KrystianRuszczak/Frequency_Meter_PCB/pcb_design/Frequency_Meter.kicad_pcb

## KiCad design pcb_design/Frequency_Meter.kicad_pcb (2026-11-03)

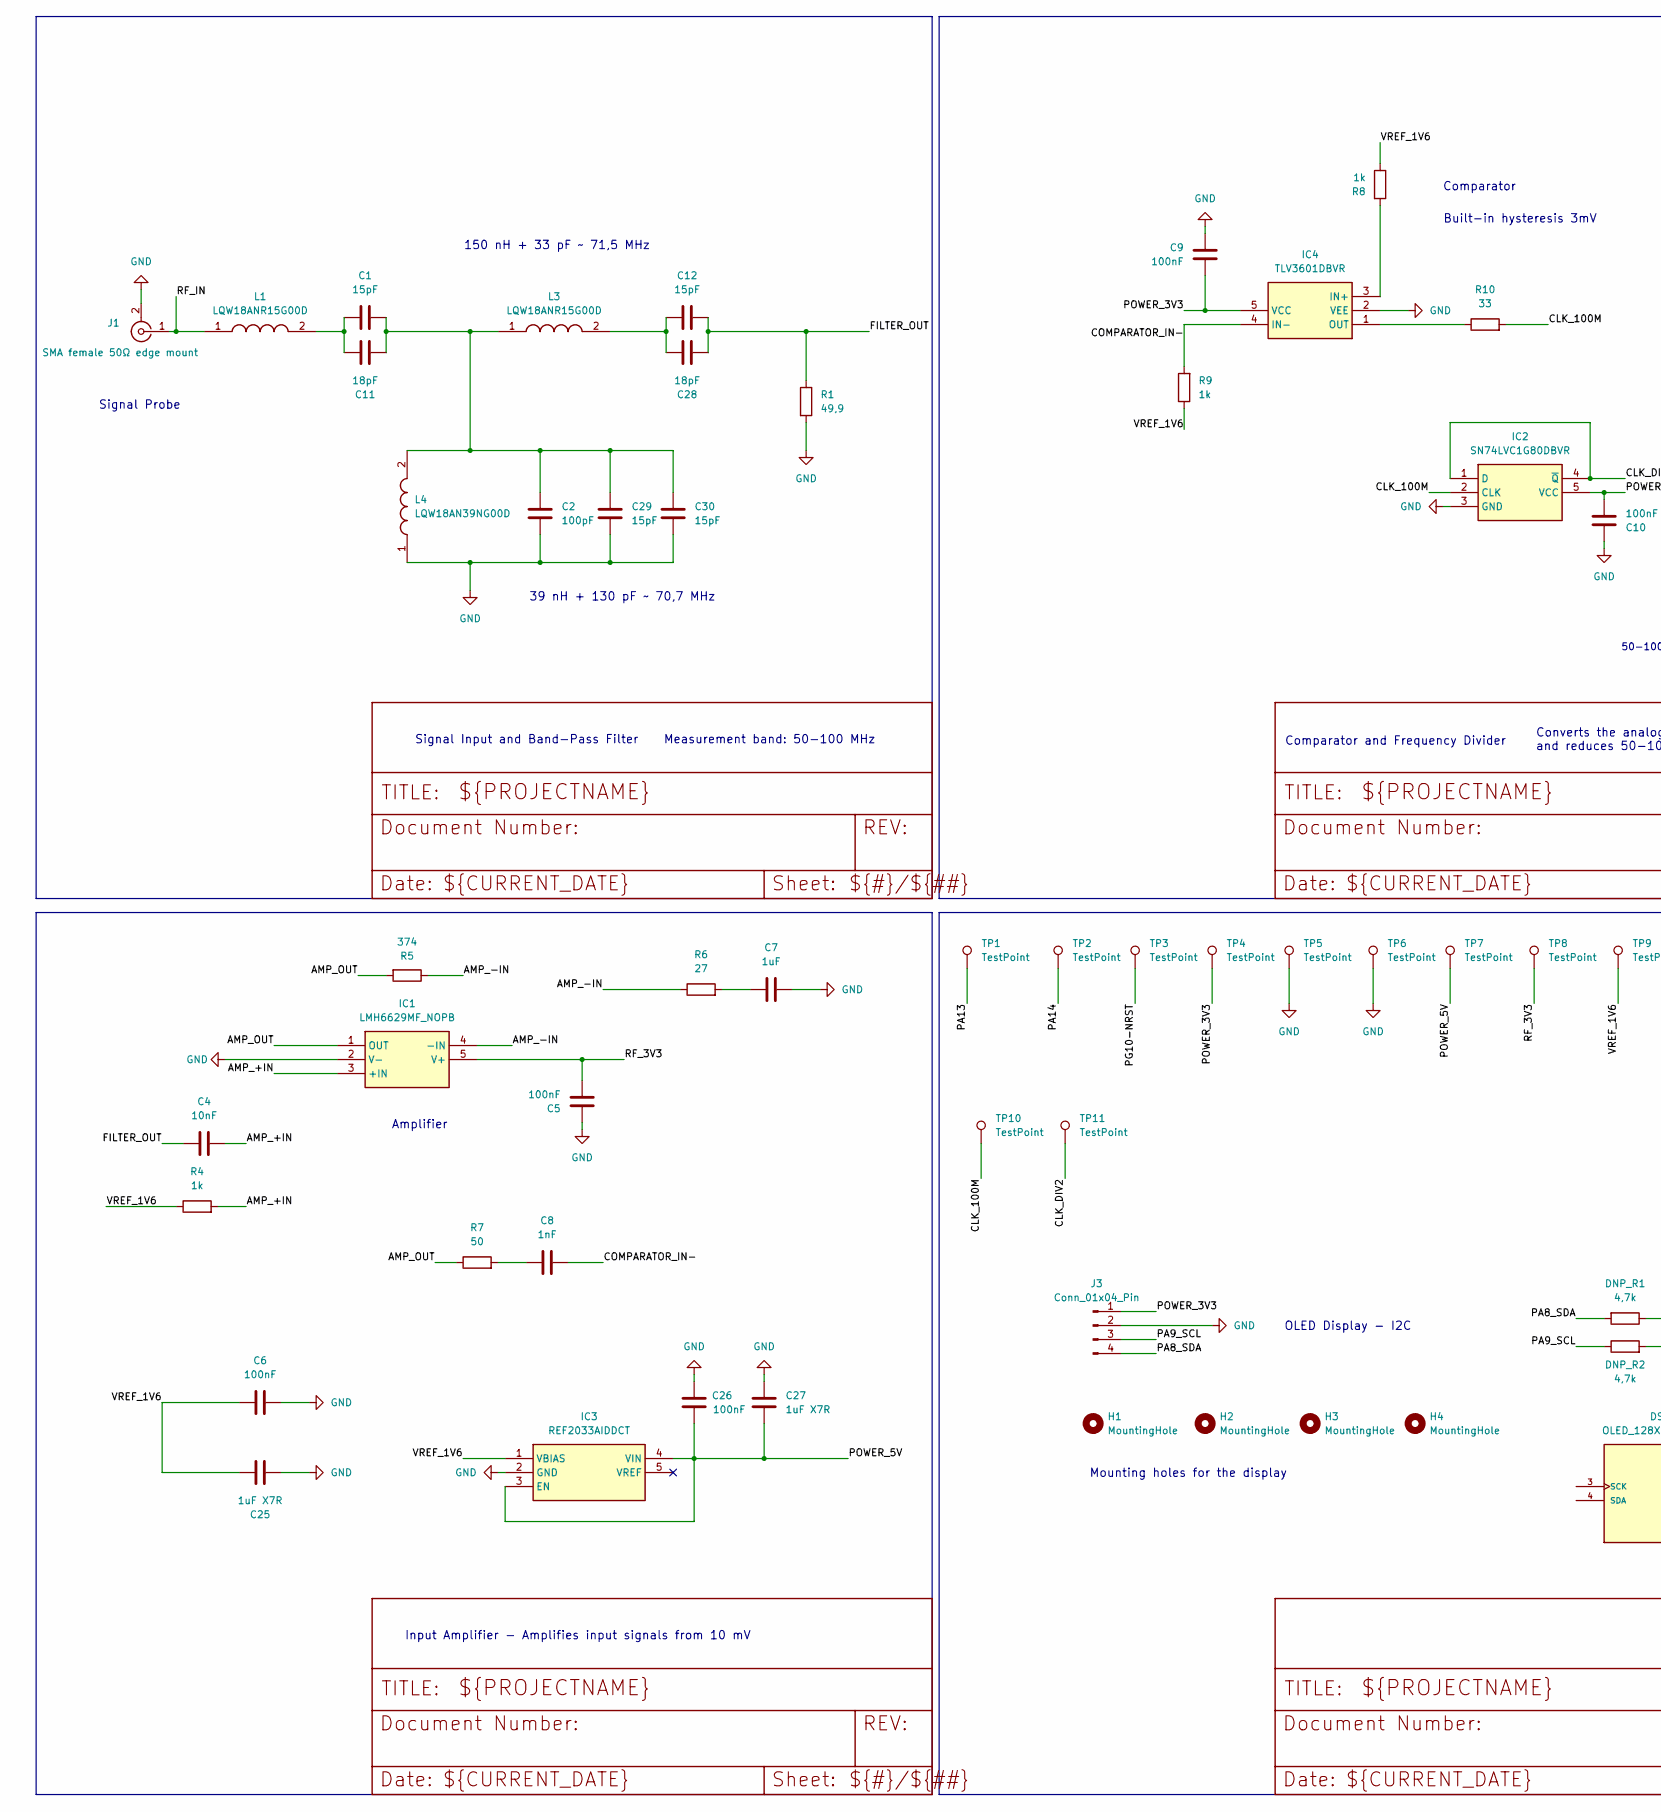
[picture p1: schematic Frequency_Meter.kicad_sch, FREQUENCY METER 50 - 100 MHz, part in row 1, column 1]

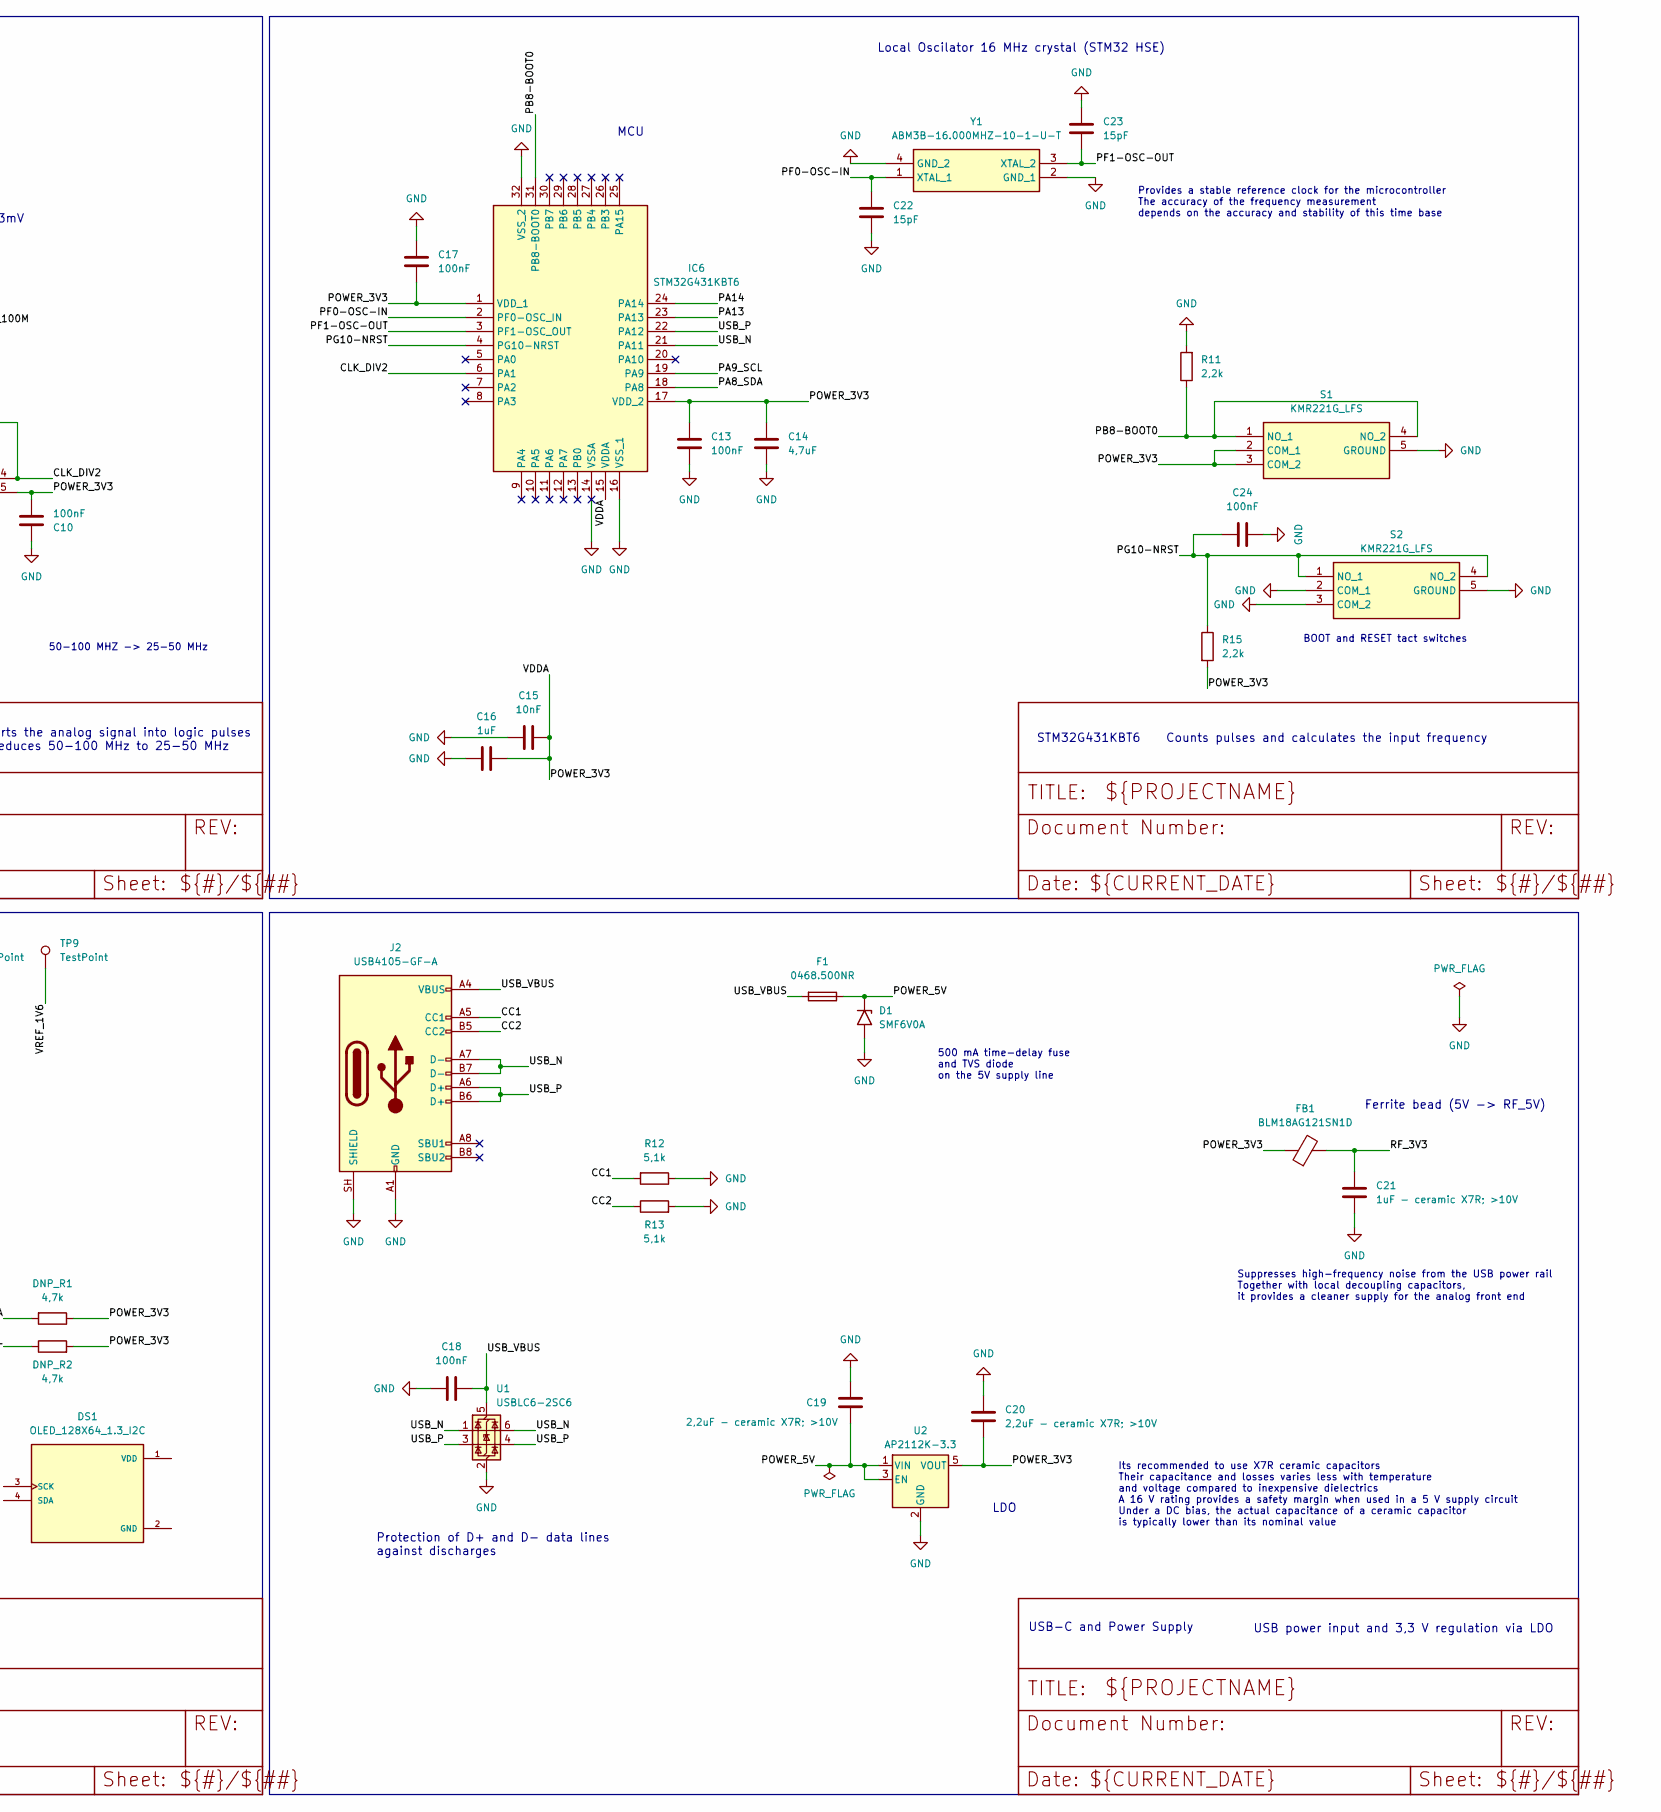
[picture p2: schematic Frequency_Meter.kicad_sch, FREQUENCY METER 50 - 100 MHz, part in row 1, column 2]

Parts:
C1, C12, C22, C23, C29, C30: 15pF; C_0603_1608Metric
C2: 100pF; C_0603_1608Metric
C4, C15: 10nF; C_0805_2012Metric
C5, C6, C9, C10, C13, C17, C18, C24, C26: 100nF; C_0603_1608Metric
C7, C16: 1uF; C_0805_2012Metric
C8: 1nF; C_0603_1608Metric
C11, C28: 18pF; C_0603_1608Metric
C14: 4,7uF; C_0805_2012Metric
C19, C20: 2,2uF - ceramic X7R; >10V; C_0805_2012Metric
C21: 1uF - ceramic X7R; >10V; C_0805_2012Metric
C25, C27: 1uF X7R; C_0805_2012Metric
D1: SMF6V0A; D_SMF
DNP_R1, DNP_R2: 4,7k; R_0603_1608Metric
DS1: OLED_128X64_1.3_I2C; LCD_OLED_128X64_1.3_I2C; PARTREV NA
F1: 0468.500NR; Fuse_1206_3216Metric
FB1: BLM18AG121SN1D; L_0603_1608Metric
H1, H2, H3, H4: MountingHole; MountingHole_2.2mm_M2
IC1: LMH6629MF_NOPB; SOT95P280X145-5N; Mouser Part Number 926-LMH6629MF/NOPB
IC2: SN74LVC1G80DBVR; SOT95P280X145-5N; Mouser Part Number 595-SN74LVC1G80DBVR
IC3: REF2033AIDDCT; SOT95P280X110-5N; Mouser Part Number 595-REF2033AIDDCT
IC4: TLV3601DBVR; SOT95P280X145-5N; Mouser Part Number 595-TLV3601DBVR
IC6: STM32G431KBT6; QFP80P900X900X160-32N; Manufacturer_Part_Number STM32G431KBT6
J1: SMA female 50Ω edge mount; SMA_Amphenol_132289_EdgeMount
J2: USB4105-GF-A; USB_C_Receptacle_GCT_USB4105-xx-A_16P_TopMnt_Horizontal
J3: Conn_01x04_Pin; PinSocket_1x04_P2.54mm_Vertical
L1, L3: LQW18ANR15G00D; L_0603_1608Metric; Manufacturer_Part_Number LQW18ANR15G00D
L4: LQW18AN39NG00D; L_0603_1608Metric; Manufacturer_Part_Number LQW18AN39NG00D
R1: 49,9; R_0603_1608Metric
R4, R8, R9: 1k; R_0603_1608Metric
R5: 374; R_0603_1608Metric
R6: 27; R_0603_1608Metric
R7: 50; R_0603_1608Metric
R10: 33; R_0603_1608Metric
R11, R15: 2,2k; R_0603_1608Metric
R12, R13: 5,1k; R_0603_1608Metric
S1, S2: KMR221G_LFS; KMR221GLFS; Manufacturer_Part_Number KMR221G LFS
TP1, TP2, TP3, TP4, TP5, TP6, TP7, TP8, TP9, TP10, TP11: TestPoint; TestPoint_Pad_D1.0mm
U1: USBLC6-2SC6; SOT-23-6
U2: AP2112K-3.3; SOT-23-5
Y1: ABM3B-16.000MHZ-10-1-U-T; ABM3B; Manufacturer_Part_Number ABM3B-16.000MHZ-10-1-U-T

Connections:
/AMP_+IN: C4.2, IC1.3 (+IN), R4.2
/AMP_-IN: IC1.4 (-IN), R5.1, R6.1
/AMP_OUT: IC1.1 (OUT), R5.2, R7.1
/CC1: J2.A5 (CC1), R12.2
/CC2: J2.B5 (CC2), R13.1
/CLK_100M: IC2.2 (CLK), R10.2, TP10.1 (1_1)
/CLK_DIV2: IC2.1 (D), IC2.4 (~Q), IC6.6 (PA1), TP11.1 (1_1)
/COMPARATOR_IN-: C8.1, IC4.4 (IN-), R9.2
/FILTER_OUT: C4.1, C12.2, C28.2, R1.1
/PA8_SDA: DNP_R1.2, IC6.18 (PA8), J3.4
/PA9_SCL: DNP_R2.1, IC6.19 (PA9), J3.3
/PA13: IC6.23 (PA13), TP1.1 (1_1)
/PA14: IC6.24 (PA14), TP2.1 (1_1)
/PB8-BOOT0: IC6.31 (PB8-BOOT0), R11.1, S1.1 (NO_1), S1.4 (NO_2)
/PF0-OSC-IN: C22.1, IC6.2 (PF0-OSC_IN), Y1.1 (XTAL_1)
/PF1-OSC-OUT: C23.2, IC6.3 (PF1-OSC_OUT), Y1.3 (XTAL_2)
/PG10-NRST: C24.1, IC6.4 (PG10-NRST), R15.1, S2.1 (NO_1), S2.4 (NO_2), TP3.1 (1_1)
/POWER_3V3: C9.1, C10.2, C13.1, C14.1, C15.2, C16.2, C17.1, C20.2, DNP_R1.1, DNP_R2.2, FB1.1, IC2.5 (VCC), IC4.5 (VCC), IC6.1 (VDD_1), IC6.15 (VDDA), IC6.17 (VDD_2), J3.1, R15.2, S1.2 (COM_1), S1.3 (COM_2), TP4.1 (1_1), U2.5 (VOUT)
/POWER_5V: C19.2, C26.1, C27.2, D1.1 (A1), F1.1, IC3.3 (EN), IC3.4 (VIN), TP7.1 (1_1), U2.1 (VIN), U2.3 (EN)
/RF_3V3: C5.2, C21.1, FB1.2, IC1.5 (V+), TP8.1 (1_1)
/RF_IN: J1.1 (In), L1.1
/USB_N: IC6.21 (PA11), J2.A7 (D-), J2.B7 (D-), U1.1 (I/O1), U1.6 (I/O1)
/USB_P: IC6.22 (PA12), J2.A6 (D+), J2.B6 (D+), U1.3 (I/O2), U1.4 (I/O2)
/USB_VBUS: C18.2, F1.2, J2.A4 (VBUS), J2.A9 (VBUS), J2.B4 (VBUS), J2.B9 (VBUS), U1.5 (VBUS)
/VREF_1V6: C6.1, C25.1, IC3.1 (VBIAS), R4.1, R8.1, R9.1, TP9.1 (1_1)
GND: C2.2, C5.1, C6.2, C7.2, C9.2, C10.1, C13.2, C14.2, C15.1, C16.1, C17.2, C18.1, C19.1, C20.1, C21.2, C22.2, C23.1, C24.2, C25.2, C26.2, C27.1, C29.1, C30.1, D1.2 (A2), IC1.2 (V-), IC2.3 (GND), IC3.2 (GND), IC4.2 (VEE), IC6.14 (VSSA), IC6.16 (VSS_1), IC6.32 (VSS_2), J1.2 (Ext), J2.A1 (GND), J2.A12 (GND), J2.B1 (GND), J2.B12 (GND), J2.SH (SHIELD), J3.2, L4.1, R1.2, R11.2, R12.1, R13.2, S1.5 (GROUND), S2.2 (COM_1), S2.3 (COM_2), S2.5 (GROUND), TP5.1 (1_1), TP6.1 (1_1), U1.2 (GND), U2.2 (GND), Y1.2 (GND_1), Y1.4 (GND_2)
unnamed: C1.1, C11.1, L1.2
unnamed: C1.2, C2.1, C11.2, C29.2, C30.2, L3.1, L4.2
unnamed: C7.1, R6.2
unnamed: C8.2, R7.2
unnamed: C12.1, C28.1, L3.2
unnamed: IC4.3 (IN+), R8.2
unnamed: IC4.1 (OUT), R10.1

Notes on the sheet:
Input Amplifier - Amplifies input signals from 10 mV
STM32G431KBT6 Counts pulses and calculates the input frequency
Provides a stable reference clock for the microcontroller The accuracy of the frequency measurement depends on the accuracy and stability of this time base
MCU
BOOT and RESET tact switches
Converts the analog signal into logic pulses and reduces 50-100 MHz to 25-50 MHz
LDO
Protection of D+ and D− data lines against discharges
150 nH + 33 pF ~ 71,5 MHz
Its recommended to use X7R ceramic capacitors Their capacitance and losses varies less with temperature and voltage compared to inexpensive dielectrics A 16 V rating provides a safety margin when used in a 5 V supply circuit Under a DC bias, the actual capacitance of a ceramic capacitor is typicall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
Mounting holes for the display
Comparator and Frequency Divider
500 mA time-delay fuse and TVS diode on the 5V supply line
Amplifier
Signal Input and Band-Pass Filter Measurement band: 50-100 MHz
50-100 MHZ -> 25-50 MHz
USB-C and Power Supply
Signal Probe
Suppresses high-frequency noise from the USB power rail Together with local decoupling capacitors, it provides a cleaner supply for the analog front end
Comparator
39 nH + 130 pF ~ 70,7 MHz
Ferrite bead (5V -> RF_5V)
Built-in hysteresis 3mV
OLED Display - I2C
USB power input and 3,3 V regulation via LDO
Local Oscilator 16 MHz crystal (STM32 HSE)

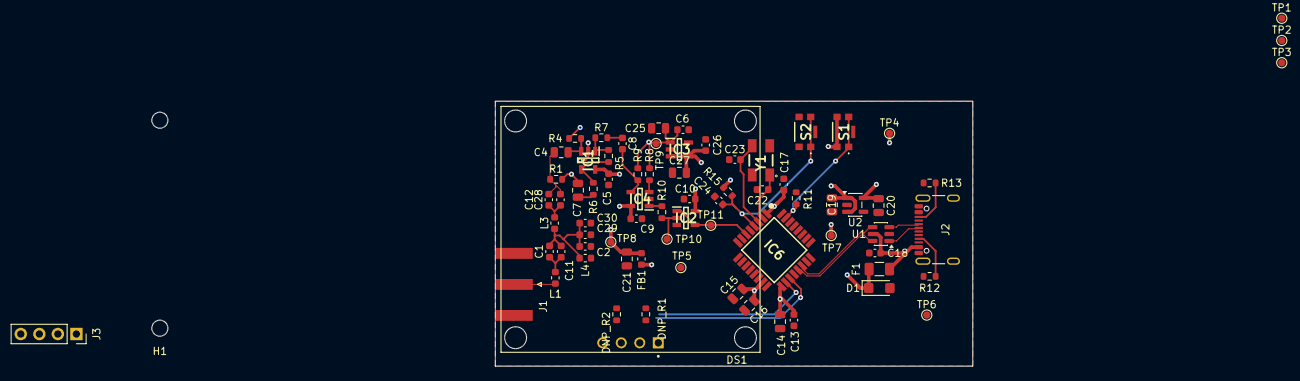
[picture p3: board Frequency_Meter.kicad_pcb from above]

Board: 4 copper layers, 65.4 x 36.3 mm, 78 parts (0 on the bottom side), 33 nets.
