KrystianRuszczak/Frequency_Meter_PCB/(commit log)

2026-10-22 Add initial frequency meter project
    [Frequency_Meter.kicad_pcb, Frequency_Meter.kicad_sch]
2026-10-24 Update schematic
    [Frequency_Meter.kicad_pcb, Frequency_Meter.kicad_sch]
2026-10-28 Schematics update
    [Frequency_Meter.kicad_pcb, Frequency_Meter.kicad_sch]
2026-10-29 PCB update
    [Frequency_Meter.kicad_pcb]
2026-11-03 update pcb
    [Frequency_Meter.kicad_pcb]
2026-11-03 Update repo
    [Frequency_Meter.kicad_pcb, Frequency_Meter.kicad_sch]
